landodoughty/Mission-Independent-Avionics-M.I.A.-/README.md

# Mission-Independent-Avionics-M.I.A.-
My Custom Rocket Avionics System
