landodoughty/Mission-Independent-Avionics-M.I.A.-/M.I.A. PCB/amass-xt30pw-m-_-pcb-solder-1.snapshot.2/Amass_XT30PW-M_pcb solder.stp

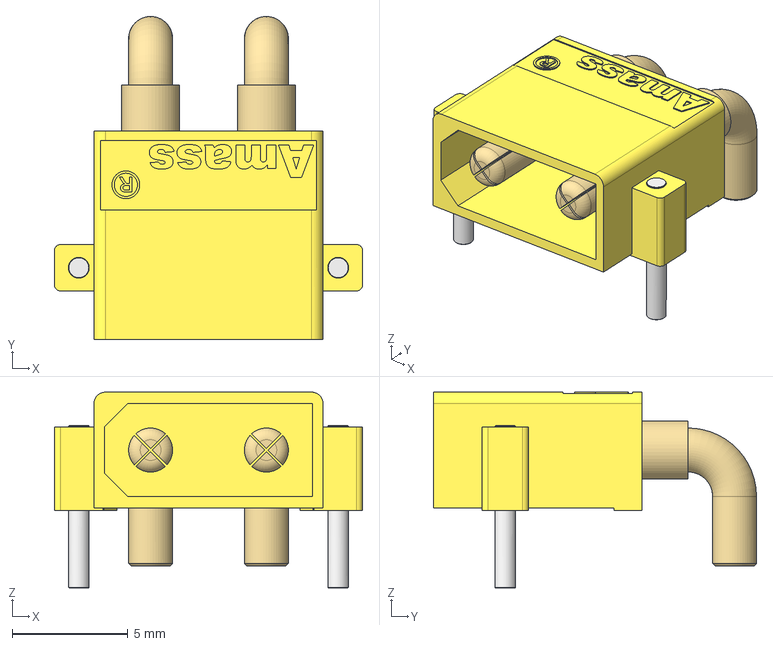
[picture p1: CAD file, 2026-05-28]
M.I.A. PCB/amass-xt30pw-m-_-pcb-solder-1.snapshot.2/Amass_XT30PW-M_pcb solder.stp
13.3 x 13.9 x 8.45 mm
