landodoughty/Mission-Independent-Avionics-M.I.A.-/M.I.A. PCB/ServoPinProtector.step

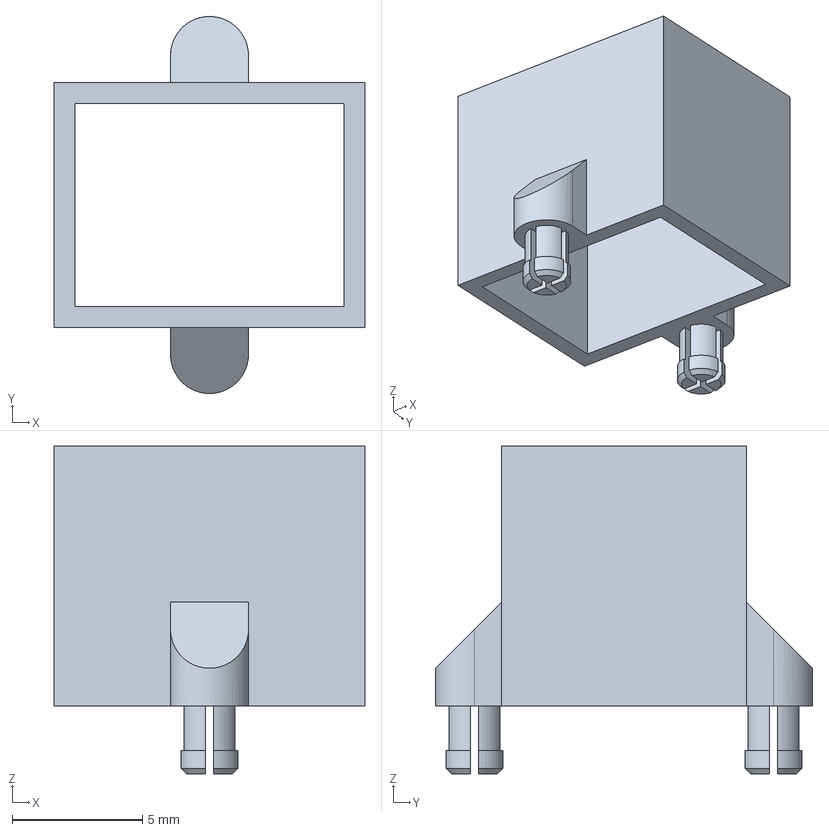
[picture p2: CAD file, 2026-05-28]
M.I.A. PCB/ServoPinProtector.step
12.0 x 14.5 x 12.6 mm
