landodoughty/Mission-Independent-Avionics-M.I.A.-/M.I.A. PCB/ScrewTerminal3d/1985823.stp

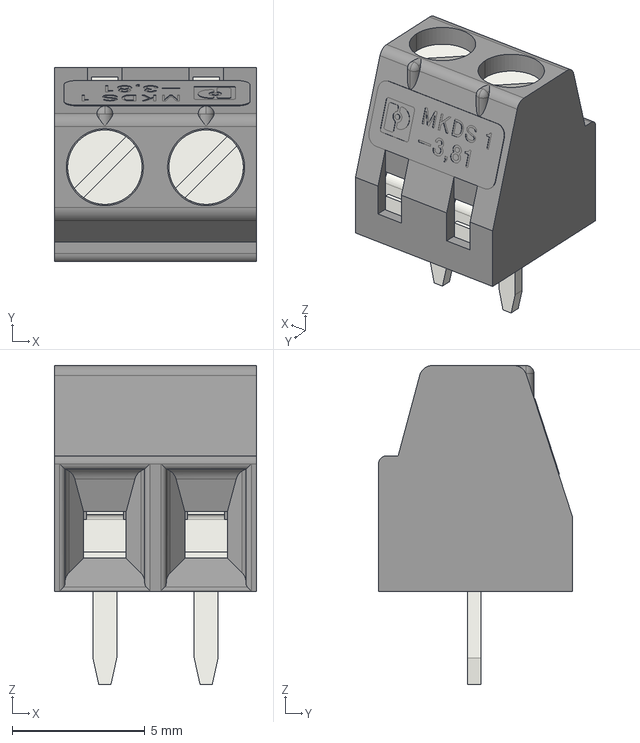
[picture p3: CAD file, 2026-05-28]
M.I.A. PCB/ScrewTerminal3d/1985823.stp
7.61 x 7.30 x 12.0 mm
