landodoughty/Mission-Independent-Avionics-M.I.A.-/M.I.A. PCB/M.I.A..kicad_pcb

## KiCad design M.I.A. PCB/M.I.A..kicad_pcb (2026-09-02)

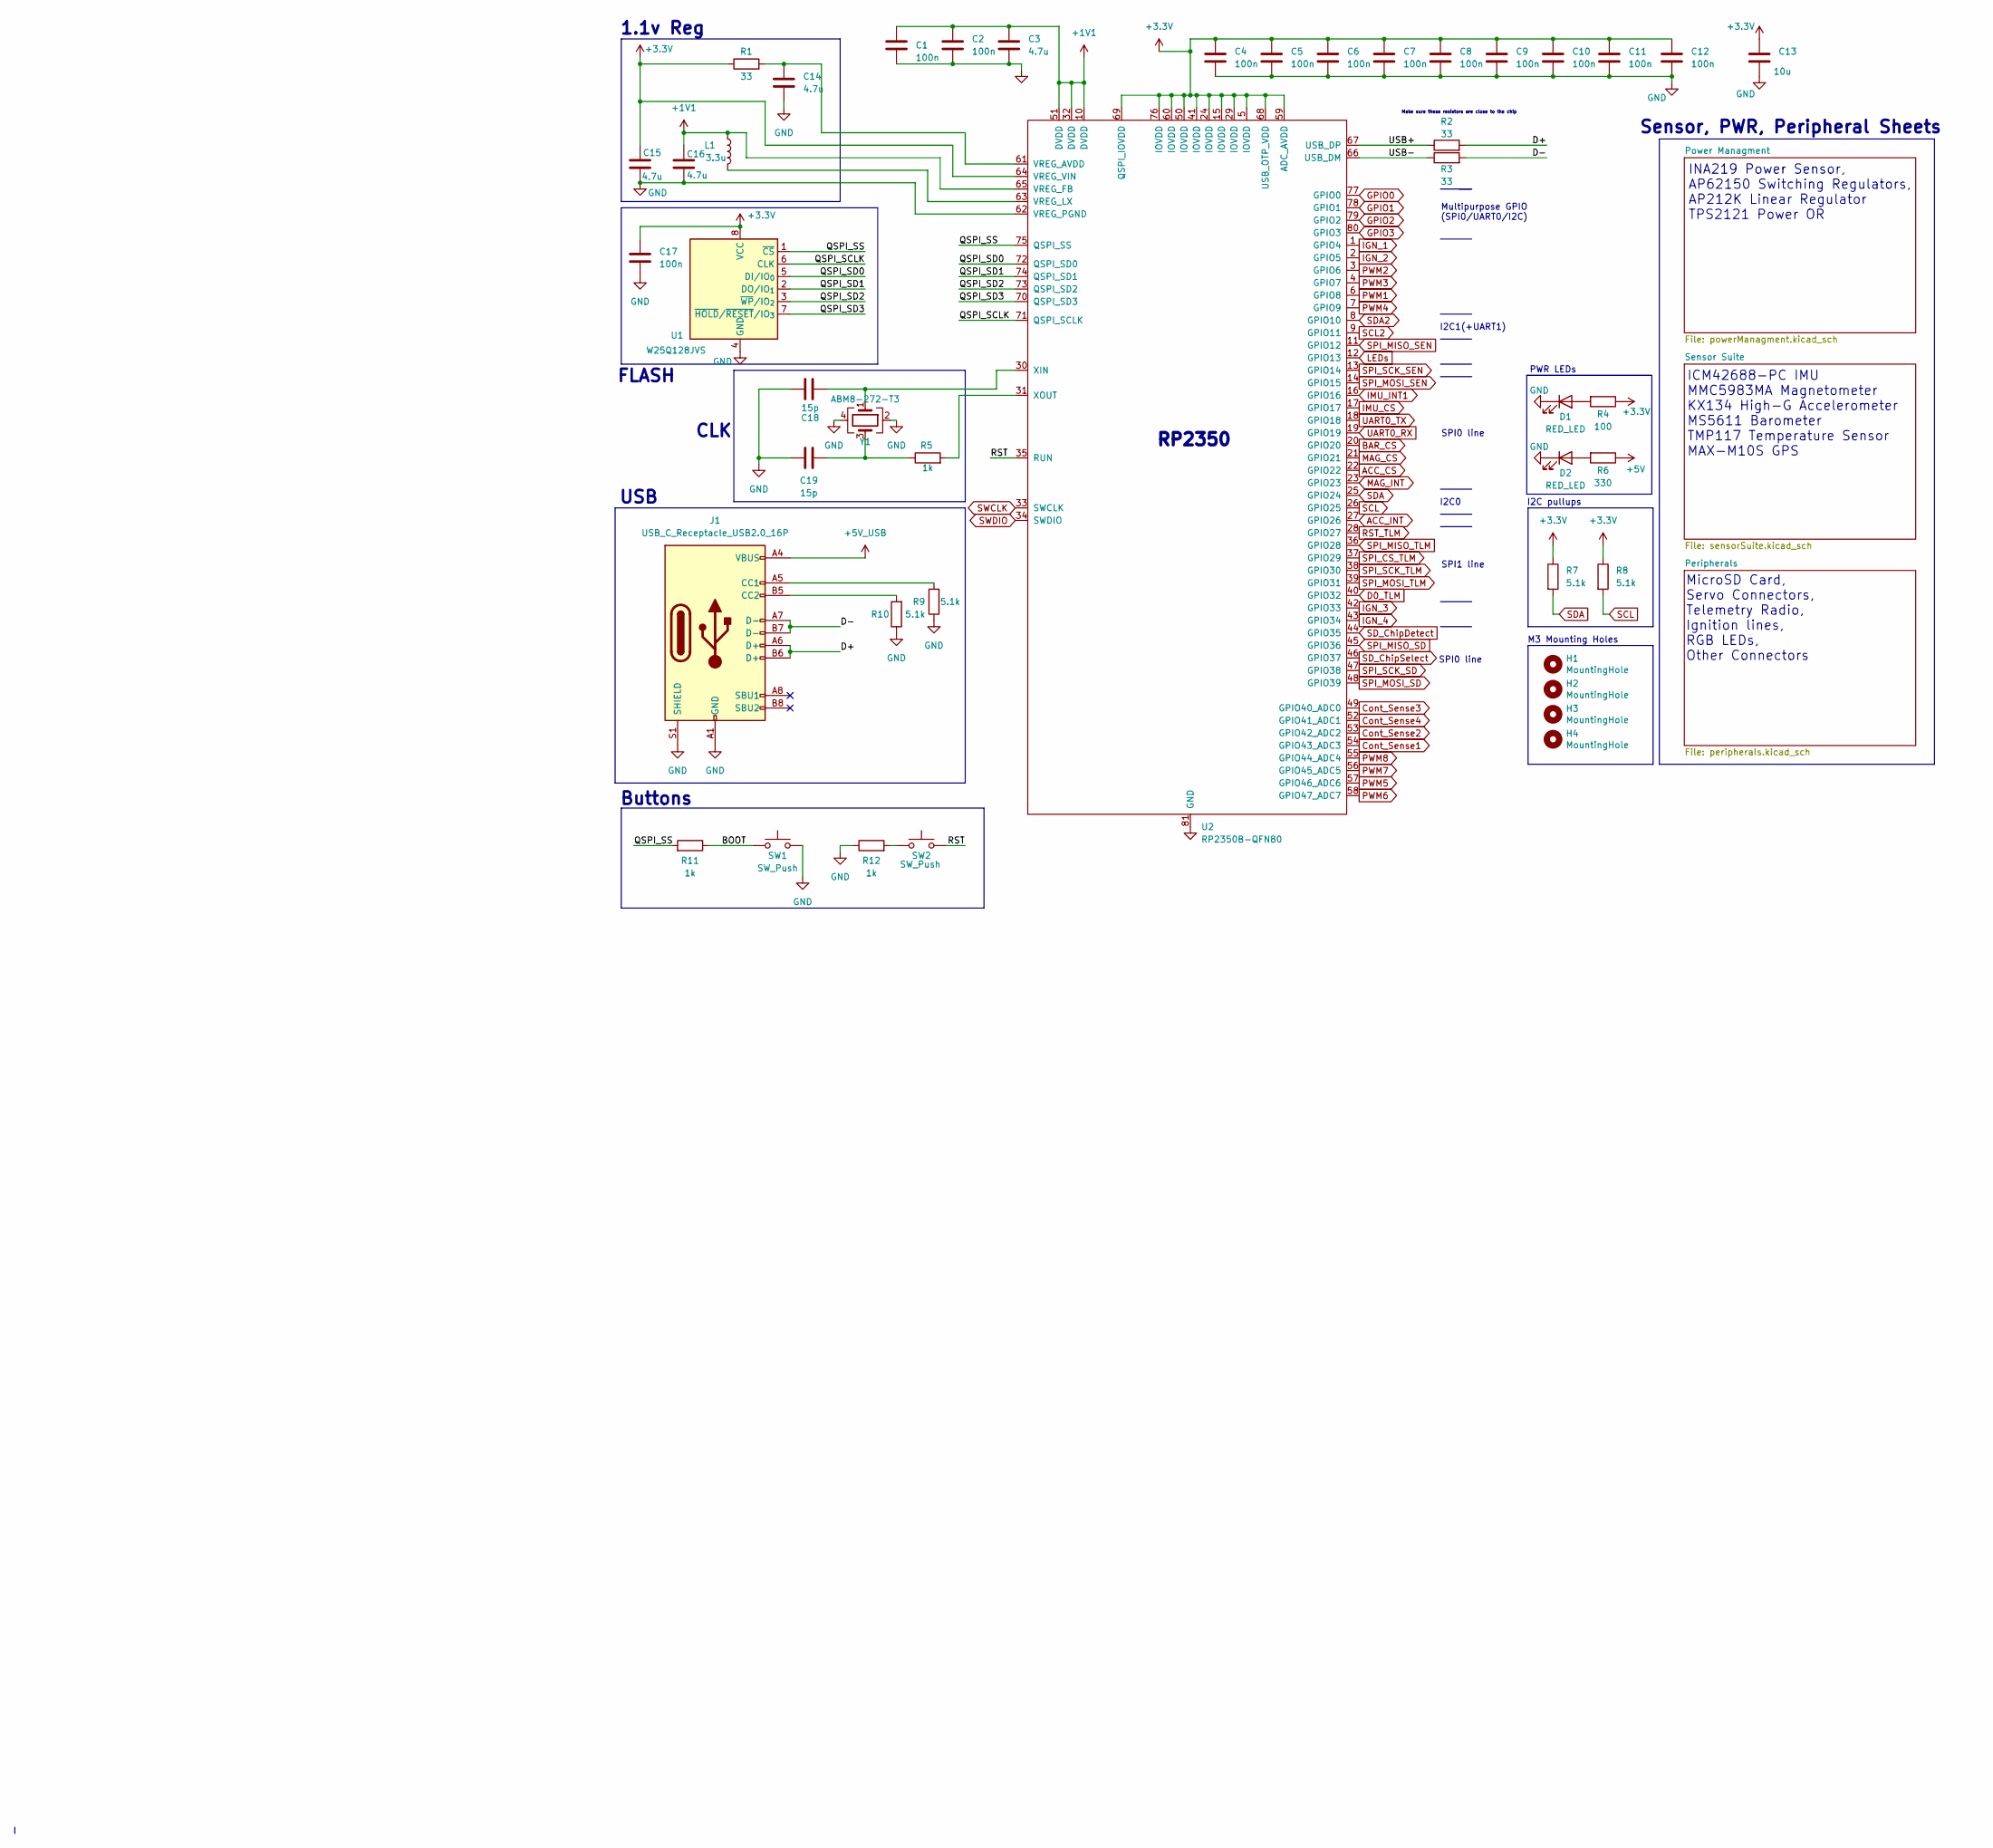
[picture p4: schematic M.I.A..kicad_sch]

Parts:
C1, C2, C4, C5, C6, C7, C8, C9, C10, C11, C12, C17: 100n; C_0603_1608Metric; LCSC Part Number C1525
C3, C14, C15, C16: 4.7u; C_0805_2012Metric; LCSC Part Number C23733
C13: 10u; C_0805_2012Metric; LCSC Part Number C15850
C18, C19: 15p; C_0603_1608Metric; LCSC Part Number C1548
D1, D2: RED_LED; LED_0805_2012Metric; LCSC Part Number C84256
H1, H2, H3, H4: MountingHole; MountingHole_3.2mm_M3_ISO14580_Pad
J1: USB_C_Receptacle_USB2.0_16P; USB_C_Receptacle_HRO_TYPE-C-31-M-12
L1: 3.3u; AOTA-B201610S3R3-101-T(L_0806_2016metric)
R1: 33; R_0603_1608Metric; LCSC Part Number C25105
R2, R3: 33; R_0603_1608Metric; LCSC Part Number C25092
R4: 100; R_0603_1608Metric; LCSC Part Number C25076
R5, R11, R12: 1k; R_0603_1608Metric; LCSC Part Number C11702
R6: 330; R_0603_1608Metric; LCSC Part Number C25076
R7, R8: 5.1k; R_0603_1608Metric; LCSC Part Number C25900
R9, R10: 5.1k; R_0603_1608Metric; LCSC Part Number C25105
SW1, SW2: SW_Push; SW_Push_SPST_NO_Alps_SKRK
U1: W25Q128JVS; WSON-8-1EP_6x5mm_P1.27mm_EP3.4x4mm; LCSC Part Number C97521
U2: RP2350B-QFN80; QFN-80-1EP_10x10mm_P0.4mm_EP3.4x3.4mm
Y1: ABM8-272-T3; Crystal_SMD_3225-4Pin_3.2x2.5mm; LCSC Part Number C20625731

Connections:
+1V1: C1.1, C2.1, C3.1, C16.1, L1.1, U2.10 (DVDD), U2.32 (DVDD), U2.51 (DVDD), U2.65 (VREG_FB)
+3.3V: C4.1, C5.1, C6.1, C7.1, C8.1, C9.1, C10.1, C11.1, C12.1, C13.1, C15.1, C17.1, R1.1, R4.1, R7.1, R8.1, U1.8 (VCC), U2.5 (IOVDD), U2.15 (IOVDD), U2.24 (IOVDD), U2.29 (IOVDD), U2.41 (IOVDD), U2.50 (IOVDD), U2.59 (ADC_AVDD), U2.60 (IOVDD), U2.64 (VREG_VIN), U2.68 (USB_OTP_VDD), U2.69 (QSPI_IOVDD), U2.76 (IOVDD); also elsewhere on the board
+5V: R6.1; also elsewhere on the board
+5V_USB: J1.A4 (VBUS), J1.A9 (VBUS), J1.B4 (VBUS), J1.B9 (VBUS); also elsewhere on the board
/BOOT: R11.1, SW1.2
/D+: J1.A6 (D+), J1.B6 (D+), R2.2
/D-: J1.A7 (D-), J1.B7 (D-), R3.2
/QSPI_SCLK: U1.6 (CLK), U2.71 (QSPI_SCLK)
/QSPI_SD0: U1.5 (DI/IO_{0}), U2.72 (QSPI_SD0)
/QSPI_SD1: U1.2 (DO/IO_{1}), U2.74 (QSPI_SD1)
/QSPI_SD2: U1.3 (~WP/IO_{2}), U2.73 (QSPI_SD2)
/QSPI_SD3: U1.7 (~HOLD/~RESET/IO_{3}), U2.70 (QSPI_SD3)
/QSPI_SS: R11.2, U1.1 (~CS), U2.75 (QSPI_SS)
/RST: SW2.2, U2.35 (RUN)
/USB+: R2.1, U2.67 (USB_DP)
/USB-: R3.1, U2.66 (USB_DM)
ACC_CS: U2.22 (GPIO22); also elsewhere on the board
ACC_INT: U2.27 (GPIO26); also elsewhere on the board
BAR_CS: U2.20 (GPIO20); also elsewhere on the board
Cont_Sense1: U2.54 (GPIO43_ADC3); also elsewhere on the board
Cont_Sense2: U2.53 (GPIO42_ADC2); also elsewhere on the board
Cont_Sense3: U2.49 (GPIO40_ADC0); also elsewhere on the board
Cont_Sense4: U2.52 (GPIO41_ADC1); also elsewhere on the board
D0_TLM: U2.40 (GPIO32); also elsewhere on the board
GND: C1.2, C2.2, C3.2, C4.2, C5.2, C6.2, C7.2, C8.2, C9.2, C10.2, C11.2, C12.2, C13.2, C14.2, C15.2, C16.2, C17.2, C18.1, C19.1, D1.1 (K), D2.1 (K), J1.A1 (GND), J1.A12 (GND), J1.B1 (GND), J1.B12 (GND), J1.S1 (SHIELD), R9.1, R10.1, R12.1, SW1.1, U1.4 (GND), U2.62 (VREG_PGND), U2.81 (GND), Y1.2, Y1.4; also elsewhere on the board
GPIO0: U2.77 (GPIO0); also elsewhere on the board
GPIO1: U2.78 (GPIO1); also elsewhere on the board
GPIO2: U2.79 (GPIO2); also elsewhere on the board
GPIO3: U2.80 (GPIO3); also elsewhere on the board
IGN_1: U2.1 (GPIO4); also elsewhere on the board
IGN_2: U2.2 (GPIO5); also elsewhere on the board
IGN_3: U2.42 (GPIO33); also elsewhere on the board
IGN_4: U2.43 (GPIO34); also elsewhere on the board
IMU_CS: U2.17 (GPIO17); also elsewhere on the board
IMU_INT1: U2.16 (GPIO16); also elsewhere on the board
LEDs: U2.12 (GPIO13); also elsewhere on the board
MAG_CS: U2.21 (GPIO21); also elsewhere on the board
MAG_INT: U2.23 (GPIO23); also elsewhere on the board
unnamed: C19.2, R5.1, Y1.3
unnamed: D1.2 (A), R4.2
unnamed: D2.2 (A), R6.2
unnamed: J1.A5 (CC1), R9.2
unnamed: J1.B5 (CC2), R10.2
unnamed: R12.2, SW2.1
unnamed: C14.1, R1.2, U2.61 (VREG_AVDD)
unnamed: L1.2, U2.63 (VREG_LX)
unnamed: C18.2, U2.30 (XIN), Y1.1
unnamed: R5.2, U2.31 (XOUT)
PWM1: U2.6 (GPIO8); also elsewhere on the board
PWM2: U2.3 (GPIO6); also elsewhere on the board
PWM3: U2.4 (GPIO7); also elsewhere on the board
PWM4: U2.7 (GPIO9); also elsewhere on the board
PWM5: U2.57 (GPIO46_ADC6); also elsewhere on the board
PWM6: U2.58 (GPIO47_ADC7); also elsewhere on the board
PWM7: U2.56 (GPIO45_ADC5); also elsewhere on the board
PWM8: U2.55 (GPIO44_ADC4); also elsewhere on the board
RST_TLM: U2.28 (GPIO27); also elsewhere on the board
SCL: R8.2, U2.26 (GPIO25); also elsewhere on the board
SCL2: U2.9 (GPIO11); also elsewhere on the board
SDA: R7.2, U2.25 (GPIO24); also elsewhere on the board
SDA2: U2.8 (GPIO10); also elsewhere on the board
SD_ChipDetect: U2.44 (GPIO35); also elsewhere on the board
SD_ChipSelect: U2.46 (GPIO37); also elsewhere on the board
SPI_CS_TLM: U2.37 (GPIO29); also elsewhere on the board
SPI_MISO_SD: U2.45 (GPIO36); also elsewhere on the board
SPI_MISO_SEN: U2.11 (GPIO12); also elsewhere on the board
SPI_MISO_TLM: U2.36 (GPIO28); also elsewhere on the board
SPI_MOSI_SD: U2.48 (GPIO39); also elsewhere on the board
SPI_MOSI_SEN: U2.14 (GPIO15); also elsewhere on the board
SPI_MOSI_TLM: U2.39 (GPIO31); also elsewhere on the board
SPI_SCK_SD: U2.47 (GPIO38); also elsewhere on the board
SPI_SCK_SEN: U2.13 (GPIO14); also elsewhere on the board
SPI_SCK_TLM: U2.38 (GPIO30); also elsewhere on the board
SWCLK: U2.33 (SWCLK); also elsewhere on the board
SWDIO: U2.34 (SWDIO); also elsewhere on the board
UART0_RX: U2.19 (GPIO19); also elsewhere on the board
UART0_TX: U2.18 (GPIO18); also elsewhere on the board

Notes on the sheet:
FLASH
Buttons
I2C0
I2C1(+UART1)
I2C pullups
SPI0 line
SPI1 line
MicroSD Card, Servo Connectors, Telemetry Radio, Ignition lines, RGB LEDs, Other Connectors
Make sure these resistors are close to the chip
USB
ICM42688-PC IMU MMC5983MA Magnetometer KX134 High-G Accelerometer MS5611 Barometer TMP117 Temperature Sensor MAX-M10S GPS
Multipurpose GPIO (SPI0/UART0/I2C)
1.1v Reg
INA219 Power Sensor, AP62150 Switching Regulators, AP212K Linear Regulator TPS2121 Power OR
CLK
PWR LEDs
RP2350
M3 Mounting Holes
Sensor, PWR, Peripheral Sheets

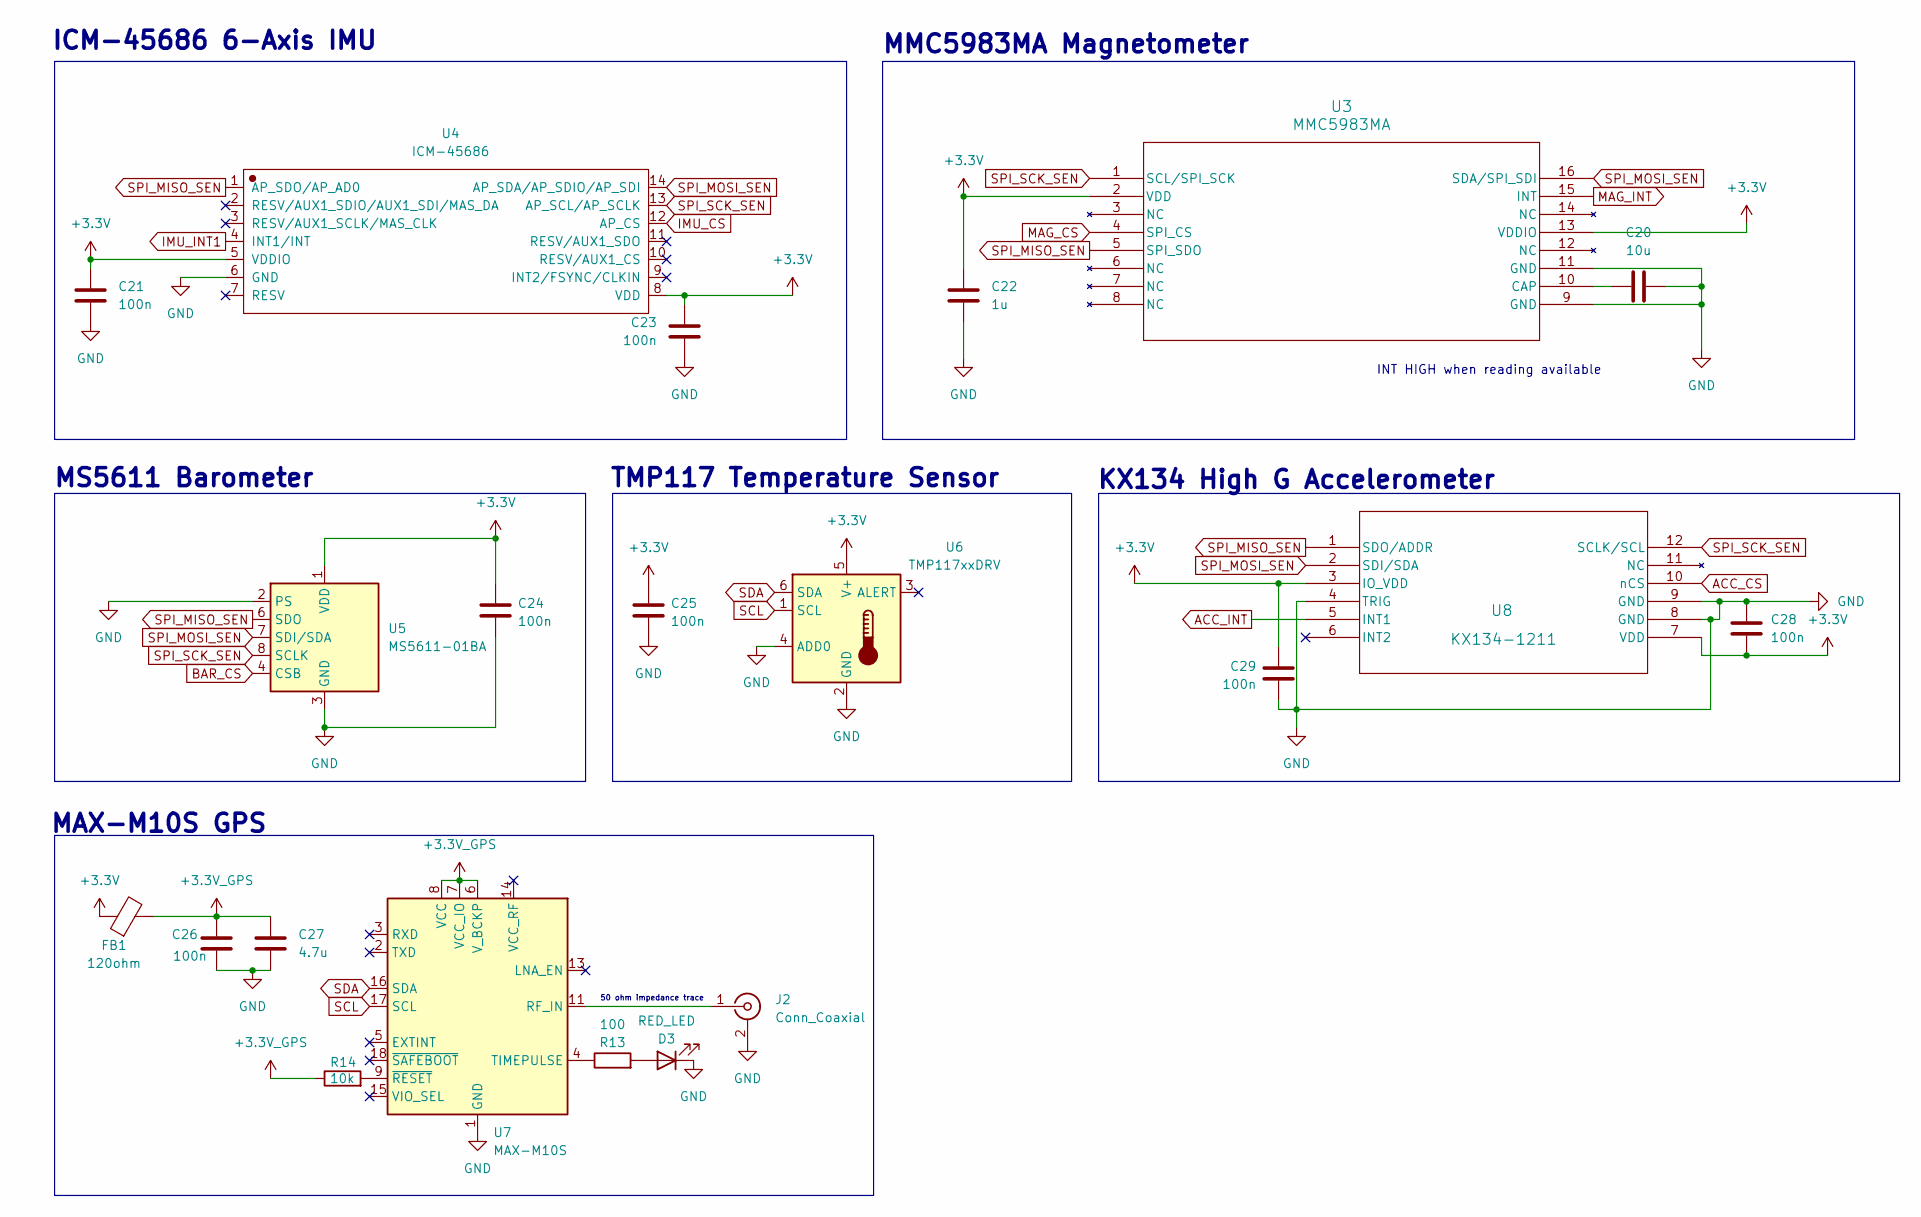
[picture p5: schematic sensorSuite.kicad_sch]

Parts:
C20: 10u; C_0805_2012Metric; LCSC Part Number C15850
C21, C23, C24, C25, C26, C28, C29: 100n; C_0603_1608Metric; LCSC Part Number C1525
C22: 1u; C_0805_2012Metric; LCSC Part Number C28323
C27: 4.7u; C_0805_2012Metric; LCSC Part Number C23733
D3: RED_LED; LED_0805_2012Metric; LCSC Part Number C84256
FB1: 120ohm; L_0805_2012Metric
J2: Conn_Coaxial; SMA_Amphenol_132134-11_Vertical
R13: 100; R_0603_1608Metric; LCSC Part Number C25076
R14: 10k; R_0603_1608Metric; LCSC Part Number C25744
U3: MMC5983MA; LGA-16_3x3mm_P0.5mm; LCSC Part Number C404329
U4: ICM-45686; Bosch_LGA-14_3x2.5mm_P0.5mm; Manufacturer Part ICM-45686; LCSC C22459454
U5: MS5611-01BA; LGA-8_3x5mm_P1.25mm; LCSC Part Number C15639
U6: TMP117xxDRV; WSON-6-1EP_2x2mm_P0.65mm_EP1x1.6mm
U7: MAX-M10S; ublox_MAX
U8: KX134-1211; LGA-12_2x2mm_P0.5mm; LCSC Part Number C2157908

Connections:
+3.3V: C21.1, C22.2, C23.1, C24.1, C25.1, C28.2, C29.1, FB1.1, U3.2 (VDD), U3.13 (VDDIO), U4.5 (VDDIO), U4.8 (VDD), U5.1 (VDD), U6.5 (V+), U8.3 (IO_VDD), U8.7 (VDD); also elsewhere on the board
+3.3V_GPS: C26.1, C27.1, FB1.2, R14.1, U7.6 (V_BCKP), U7.7 (VCC_IO), U7.8 (VCC)
ACC_CS: U8.10 (nCS); also elsewhere on the board
ACC_INT: U8.5 (INT1); also elsewhere on the board
BAR_CS: U5.4 (CSB), U5.5 (CSB); also elsewhere on the board
GND: C20.2, C21.2, C22.1, C23.2, C24.2, C25.2, C26.2, C27.2, C28.1, C29.2, D3.1 (K), J2.2 (Ext), U3.9 (GND), U3.11 (GND), U4.6 (GND), U5.2 (PS), U5.3 (GND), U6.2 (GND), U6.4 (ADD0), U7.1 (GND), U7.10 (GND), U7.12 (GND), U8.4 (TRIG), U8.8 (GND), U8.9 (GND); also elsewhere on the board
IMU_CS: U4.12 (AP_CS); also elsewhere on the board
IMU_INT1: U4.4 (INT1/INT); also elsewhere on the board
MAG_CS: U3.4 (SPI_CS); also elsewhere on the board
MAG_INT: U3.15 (INT); also elsewhere on the board
unnamed: D3.2 (A), R13.2
unnamed: J2.1 (In), U7.11 (RF_IN)
unnamed: C20.1, U3.10 (CAP)
unnamed: R13.1, U7.4 (TIMEPULSE)
unnamed: R14.2, U7.9 (~RESET)
SCL: U6.1 (SCL), U7.17 (SCL); also elsewhere on the board
SDA: U6.6 (SDA), U7.16 (SDA); also elsewhere on the board
SPI_MISO_SEN: U3.5 (SPI_SDO), U4.1 (AP_SDO/AP_AD0), U5.6 (SDO), U8.1 (SDO/ADDR); also elsewhere on the board
SPI_MOSI_SEN: U3.16 (SDA/SPI_SDI), U4.14 (AP_SDA/AP_SDIO/AP_SDI), U5.7 (SDI/SDA), U8.2 (SDI/SDA); also elsewhere on the board
SPI_SCK_SEN: U3.1 (SCL/SPI_SCK), U4.13 (AP_SCL/AP_SCLK), U5.8 (SCLK), U8.12 (SCLK/SCL); also elsewhere on the board

Notes on the sheet:
MMC5983MA Magnetometer
MS5611 Barometer
INT HIGH when reading available
ICM-45686 6-Axis IMU
TMP117 Temperature Sensor
KX134 High G Accelerometer
MAX-M10S GPS
50 ohm impedance trace

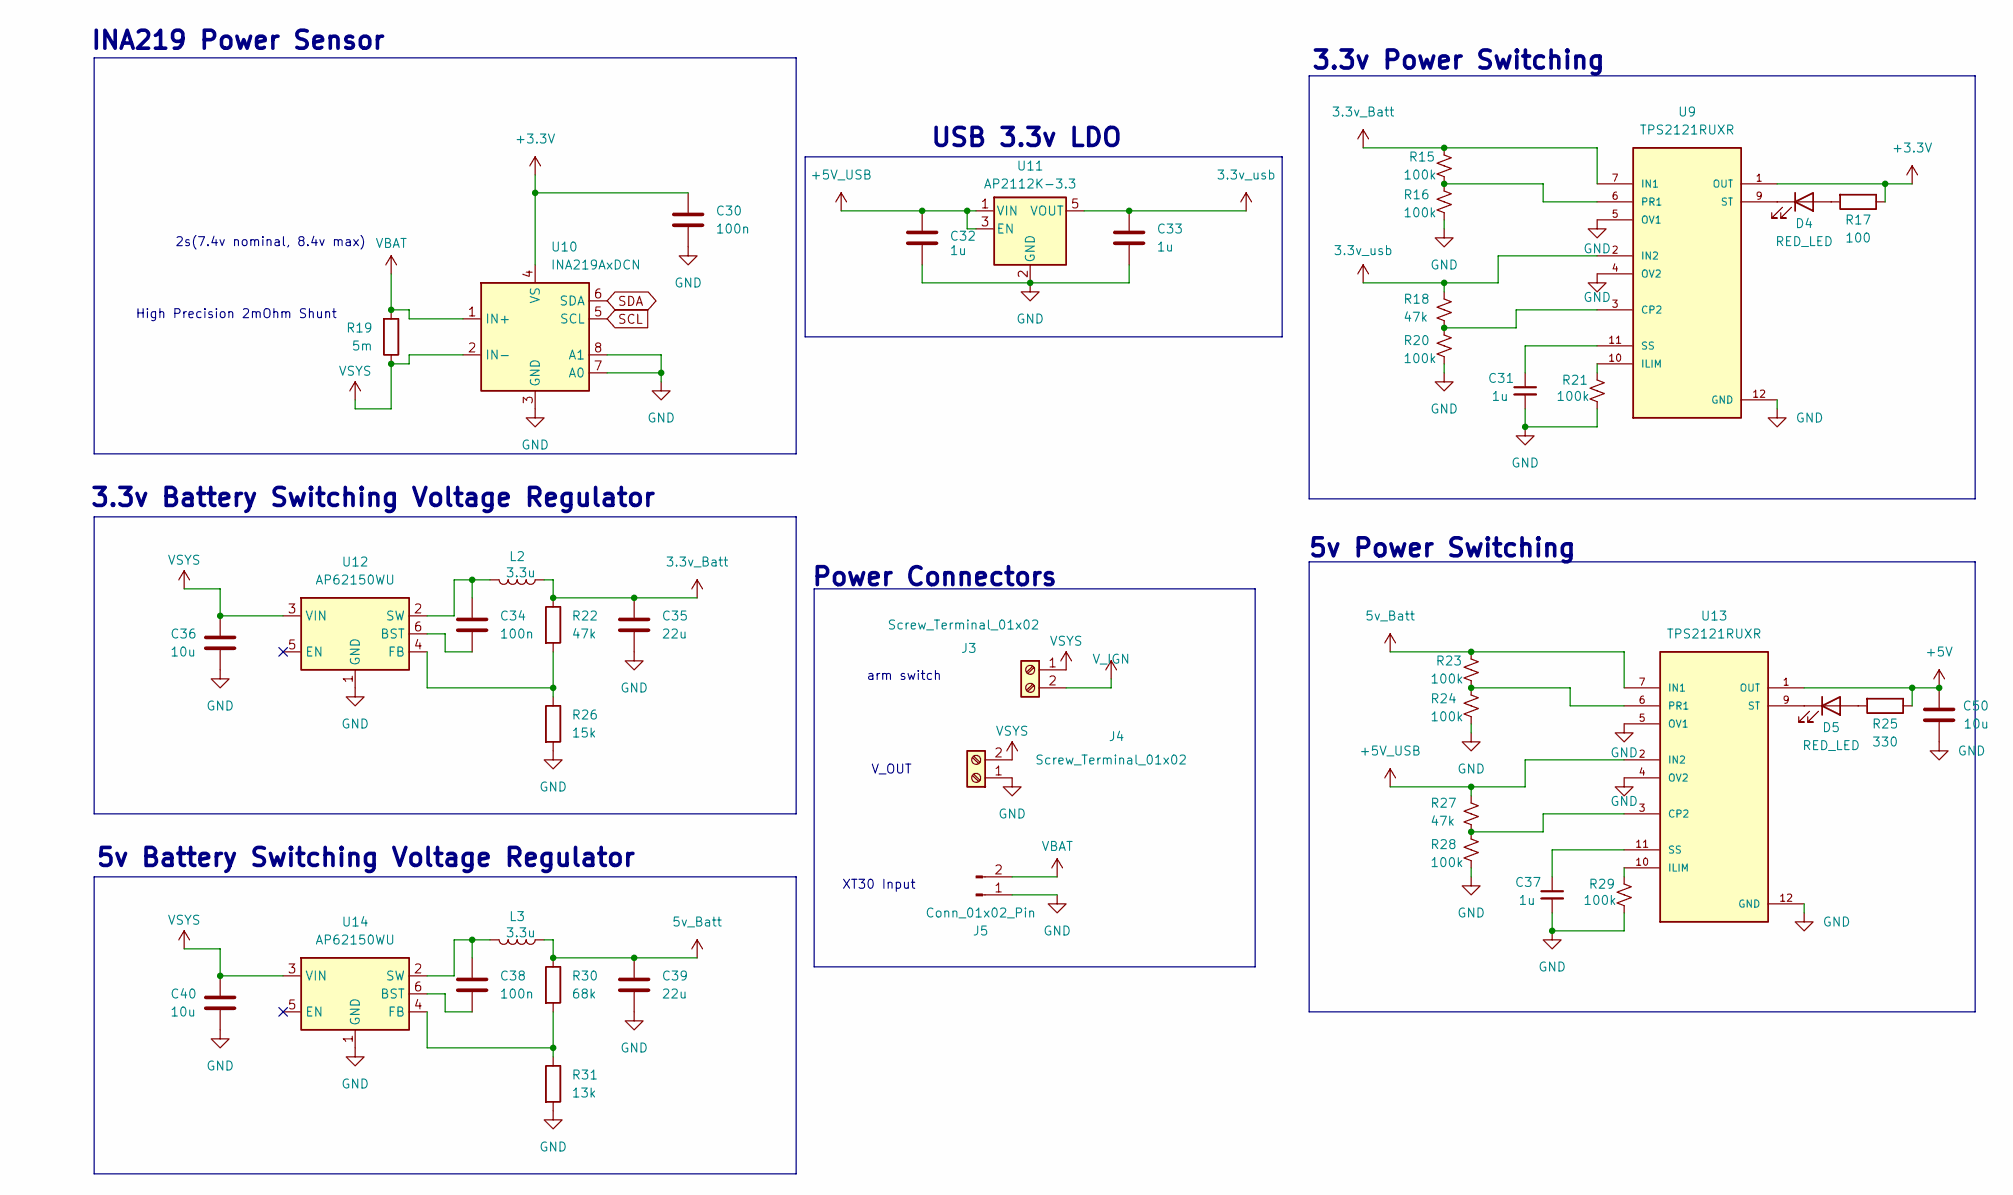
[picture p6: schematic powerManagment.kicad_sch]

Parts:
C30, C34, C38: 100n; C_0603_1608Metric; LCSC Part Number C1525
C31, C37: 1u; C_0805_2012Metric; LCSC Part Number C28323
C32, C33: 1u; C_0805_2012Metric; LCSC Part Number C15850
C35, C39: 22u; C_0805_2012Metric; LCSC Part Number C45783
C36, C40, C50: 10u; C_0805_2012Metric; JLCPCB Part # C15850
D4, D5: RED_LED; LED_0805_2012Metric; LCSC Part Number C84256
J3, J4: Screw_Terminal_01x02; ScrewTerminal_1x02_P3.5mm_Horizontal_Black
J5: Conn_01x02_Pin; AMASS_XT30PW-M_1x02_P2.50mm_Horizontal
L2, L3: 3.3u; AOTA-B201610S3R3-101-T(L_0806_2016metric)
R15, R23: 100k; R_0603_1608Metric; LCSC Part Number C25792
R16, R20, R21, R24, R28, R29: 100k; R_0603_1608Metric; LCSC Part Number C25741
R17: 100; R_0603_1608Metric; LCSC Part Number C25076
R18, R27: 47k; R_0603_1608Metric; LCSC Part Number C25741
R19: 5m; R_1206_3216Metric
R22: 47k; R_0603_1608Metric; LCSC Part Number C25792
R25: 330; R_0603_1608Metric; LCSC Part Number C25076
R26: 15k; R_0603_1608Metric; LCSC Part Number C25756
R30: 68k; R_0603_1608Metric; LCSC Part Number C25792
R31: 13k; R_0603_1608Metric; LCSC Part Number C25756
U9, U13: TPS2121RUXR; Texas_VQFN-HR-12_2x2.5mm_P0.5mm; LCSC Part Number C485916
U10: INA219AxDCN; SOT-23-8
U11: AP2112K-3.3; SOT-23-5
U12, U14: AP62150WU; TSOT-23-6; LCSC Part Number C3194237

Connections:
3.3v_Batt: C35.1, L2.1, R15.1, R22.1, U9.7 (IN1)
3.3v_usb: C33.1, R18.1, U9.2 (IN2), U11.5 (VOUT)
5v_Batt: C39.1, L3.1, R23.1, R30.1, U13.7 (IN1)
+3.3V: C30.1, R17.1, U9.1 (OUT), U9.8 (OUT), U10.4 (VS); also elsewhere on the board
+5V: C50.1, R25.1, U13.1 (OUT), U13.8 (OUT); also elsewhere on the board
+5V_USB: C32.1, R27.1, U11.1 (VIN), U11.3 (EN), U13.2 (IN2); also elsewhere on the board
GND: C30.2, C31.2, C32.2, C33.2, C35.2, C36.2, C37.2, C39.2, C40.2, C50.2, J4.1, J5.1, R16.2, R20.2, R21.2, R24.2, R26.2, R28.2, R29.2, R31.2, U9.4 (OV2), U9.5 (OV1), U9.12 (GND), U10.3 (GND), U10.7 (A0), U10.8 (A1), U11.2 (GND), U12.1 (GND), U13.4 (OV2), U13.5 (OV1), U13.12 (GND), U14.1 (GND); also elsewhere on the board
unnamed: D4.2 (A), R17.2
unnamed: D4.1 (K), U9.9 (ST)
unnamed: D5.2 (A), R25.2
unnamed: D5.1 (K), U13.9 (ST)
unnamed: R18.2, R20.1, U9.3 (CP2)
unnamed: R21.1, U9.10 (ILIM)
unnamed: R15.2, R16.1, U9.6 (PR1)
unnamed: C31.1, U9.11 (SS)
unnamed: C34.2, U12.6 (BST)
unnamed: R22.2, R26.1, U12.4 (FB)
unnamed: C34.1, L2.2, U12.2 (SW)
unnamed: R27.2, R28.1, U13.3 (CP2)
unnamed: R29.1, U13.10 (ILIM)
unnamed: R23.2, R24.1, U13.6 (PR1)
unnamed: C37.1, U13.11 (SS)
unnamed: C38.2, U14.6 (BST)
unnamed: R30.2, R31.1, U14.4 (FB)
unnamed: C38.1, L3.2, U14.2 (SW)
SCL: U10.5 (SCL); also elsewhere on the board
SDA: U10.6 (SDA); also elsewhere on the board
VBAT: J5.2, R19.2, U10.1 (IN+)
VSYS: C36.1, C40.1, J3.1, J4.2, R19.1, U10.2 (IN-), U12.3 (VIN), U14.3 (VIN); also elsewhere on the board
V_IGN: J3.2; also elsewhere on the board

Notes on the sheet:
Power Connectors
3.3v Battery Switching Voltage Regulator
5v Power Switching
arm switch
3.3v Power Switching
V_OUT
INA219 Power Sensor
XT30 Input
5v Battery Switching Voltage Regulator
2s(7.4v nominal, 8.4v max)
USB 3.3v LDO
High Precision 2mOhm Shunt

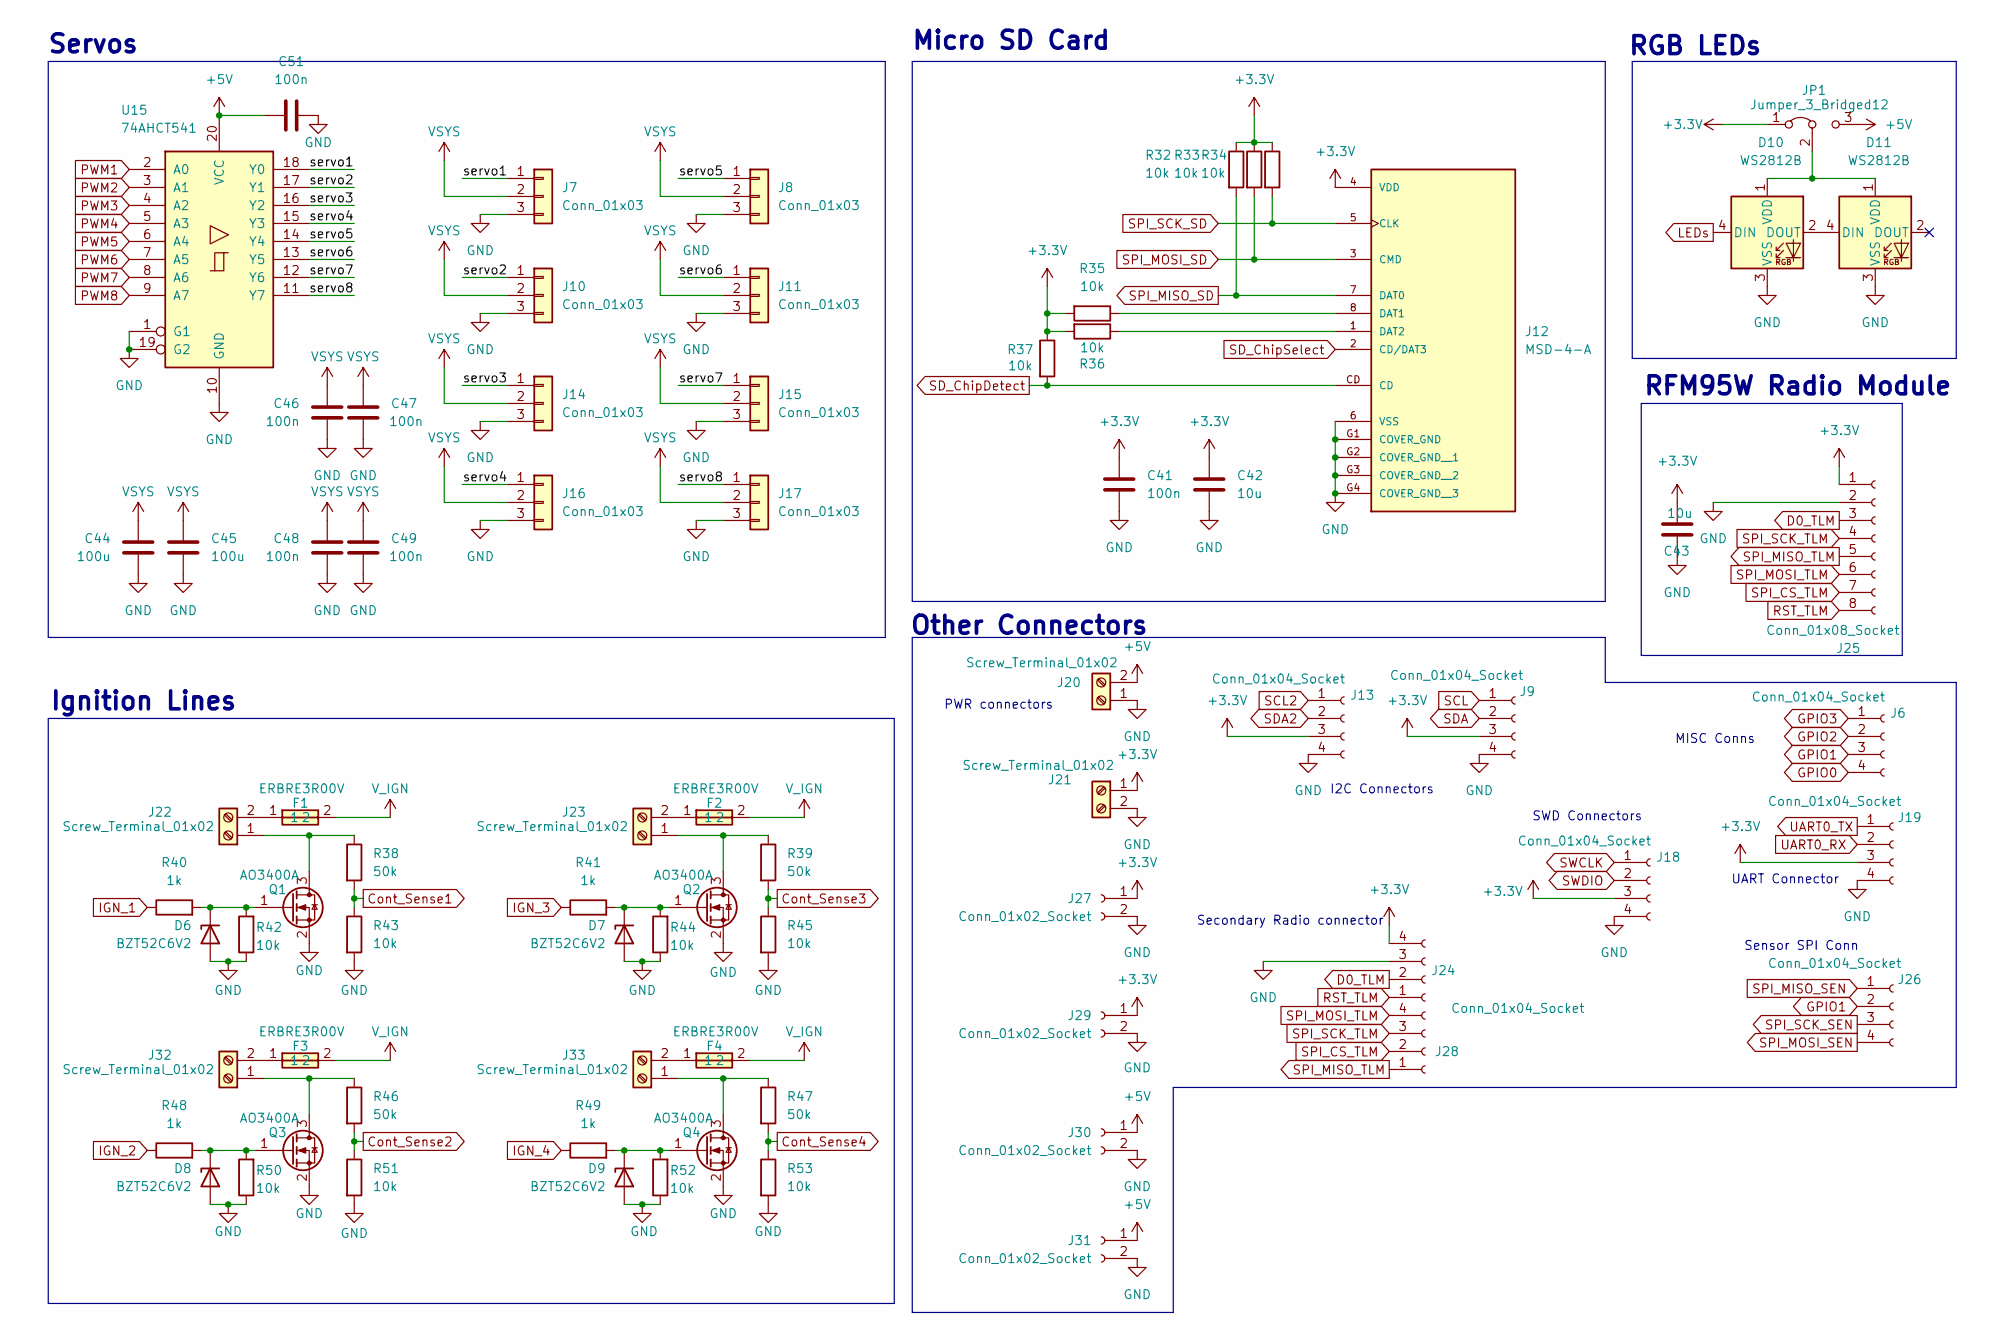
[picture p7: schematic peripherals.kicad_sch]

Parts:
C41, C51: 100n; C_0603_1608Metric; LCSC Part Number C1525
C42: 10u; C_0805_2012Metric; LCSC Part Number C15850
C43: 10u; C_0805_2012Metric
C44, C45: 100u; C_Radial_D5.0mm_H11.0mm_P2.00mm; LCSC Part Number C15850
C46, C47, C48, C49: 100n; C_0603_1608Metric; LCSC Part Number C15850
D6, D7, D8, D9: BZT52C6V2; D_SOD-123F
D10, D11: WS2812B; LED_WS2812B_PLCC4_5.0x5.0mm_P3.2mm
F1, F2, F3, F4: ERBRE3R00V; Manufacturer Part ERBRE3R00V; LCSC C713406
J6, J9, J13, J18, J19, J24, J26, J28: Conn_01x04_Socket; JST_PH_B4B-PH-K_1x04_P2.00mm_Vertical
J7, J8, J10, J11, J14, J15, J16, J17: Conn_01x03; PinHeader_1x03_P2.54mm_Vertical
J12: MSD-4-A; CUI_MSD-4-A; PARTREV 1.0
J20, J21, J22, J23, J32, J33: Screw_Terminal_01x02; ScrewTerminal_1x02_P3.5mm_Horizontal_Black
J25: Conn_01x08_Socket; JST_SHL_SM08B-SHLS-TF_1x08-1MP_P1.00mm_Horizontal
J27, J29, J30, J31: Conn_01x02_Socket; JST_PH_B2B-PH-K_1x02_P2.00mm_Vertical
JP1: Jumper_3_Bridged12; SolderJumper-3_P1.3mm_Bridged12_RoundedPad1.0x1.5mm_NumberL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
Q1, Q2, Q3, Q4: AO3400A; SOT-23
R32, R33, R34, R35, R36, R37: 10k; R_0603_1608Metric; LCSC Part Number C25744
R38, R39, R46, R47: 50k; R_0603_1608Metric
R40, R41, R48, R49: 1k; R_0603_1608Metric
R42, R43, R44, R45, R50, R51, R52, R53: 10k; R_0603_1608Metric
U15: 74AHCT541; SSOP-20_4.4x6.5mm_P0.65mm

Connections:
+3.3V: C41.1, C42.1, C43.1, J9.3, J12.4 (VDD), J13.3, J18.3, J19.3, J21.1, J24.4, J25.1, J27.1, J29.1, JP1.1 (A), R32.1, R33.1, R34.1, R35.2, R36.2, R37.1; also elsewhere on the board
+5V: C51.1, J20.2, J30.1, J31.1, JP1.3 (B), U15.20 (VCC); also elsewhere on the board
/Peripherals/servo1: J7.1, U15.18 (Y0)
/Peripherals/servo2: J10.1, U15.17 (Y1)
/Peripherals/servo3: J14.1, U15.16 (Y2)
/Peripherals/servo4: J16.1, U15.15 (Y3)
/Peripherals/servo5: J8.1, U15.14 (Y4)
/Peripherals/servo6: J11.1, U15.13 (Y5)
/Peripherals/servo7: J15.1, U15.12 (Y6)
/Peripherals/servo8: J17.1, U15.11 (Y7)
Cont_Sense1: R38.2, R43.1; also elsewhere on the board
Cont_Sense2: R46.2, R51.1; also elsewhere on the board
Cont_Sense3: R39.2, R45.1; also elsewhere on the board
Cont_Sense4: R47.2, R53.1; also elsewhere on the board
D0_TLM: J24.2, J25.3; also elsewhere on the board
GND: C41.2, C42.2, C43.2, C44.2, C45.2, C46.2, C47.2, C48.2, C49.2, C51.2, D6.2 (A), D7.2 (A), D8.2 (A), D9.2 (A), D10.3 (VSS), D11.3 (VSS), J7.3, J8.3, J9.4, J10.3, J11.3, J12.6 (VSS), J12.G1 (COVER_GND), J12.G2 (COVER_GND__1), J12.G3 (COVER_GND__2), J12.G4 (COVER_GND__3), J13.4, J14.3, J15.3, J16.3, J17.3, J18.4, J19.4, J20.1, J21.2, J24.3, J25.2, J27.2, J29.2, J30.2, J31.2, Q1.2 (S), Q2.2 (S), Q3.2 (S), Q4.2 (S), R42.1, R43.2, R44.1, R45.2, R50.1, R51.2, R52.1, R53.2, U15.1 (G1), U15.10 (GND), U15.19 (G2); also elsewhere on the board
GPIO0: J6.4; also elsewhere on the board
GPIO1: J6.3, J26.2; also elsewhere on the board
GPIO2: J6.2; also elsewhere on the board
GPIO3: J6.1; also elsewhere on the board
IGN_1: R40.1; also elsewhere on the board
IGN_2: R48.1; also elsewhere on the board
IGN_3: R41.1; also elsewhere on the board
IGN_4: R49.1; also elsewhere on the board
LEDs: D10.4 (DIN); also elsewhere on the board
unnamed: D6.1 (K), Q1.1 (G), R40.2, R42.2
unnamed: D7.1 (K), Q2.1 (G), R41.2, R44.2
unnamed: D8.1 (K), Q3.1 (G), R48.2, R50.2
unnamed: D9.1 (K), Q4.1 (G), R49.2, R52.2
unnamed: D10.2 (DOUT), D11.4 (DIN)
unnamed: D10.1 (VDD), D11.1 (VDD), JP1.2 (C)
unnamed: J12.8 (DAT1), R35.1
unnamed: J12.1 (DAT2), R36.1
unnamed: J22.1, Q1.3 (D), R38.1
unnamed: F1.1, J22.2
unnamed: J23.1, Q2.3 (D), R39.1
unnamed: F2.1, J23.2
unnamed: J32.1, Q3.3 (D), R46.1
unnamed: F3.1, J32.2
unnamed: J33.1, Q4.3 (D), R47.1
unnamed: F4.1, J33.2
PWM1: U15.2 (A0); also elsewhere on the board
PWM2: U15.3 (A1); also elsewhere on the board
PWM3: U15.4 (A2); also elsewhere on the board
PWM4: U15.5 (A3); also elsewhere on the board
PWM5: U15.6 (A4); also elsewhere on the board
PWM6: U15.7 (A5); also elsewhere on the board
PWM7: U15.8 (A6); also elsewhere on the board
PWM8: U15.9 (A7); also elsewhere on the board
RST_TLM: J24.1, J25.8; also elsewhere on the board
SCL: J9.1; also elsewhere on the board
SCL2: J13.1; also elsewhere on the board
SDA: J9.2; also elsewhere on the board
SDA2: J13.2; also elsewhere on the board
SD_ChipDetect: J12.CD, R37.2; also elsewhere on the board
SD_ChipSelect: J12.2 (CD/DAT3); also elsewhere on the board
SPI_CS_TLM: J25.7, J28.2; also elsewhere on the board
SPI_MISO_SD: J12.7 (DAT0), R32.2; also elsewhere on the board
SPI_MISO_SEN: J26.1; also elsewhere on the board
SPI_MISO_TLM: J25.5, J28.1; also elsewhere on the board
SPI_MOSI_SD: J12.3 (CMD), R33.2; also elsewhere on the board
SPI_MOSI_SEN: J26.4; also elsewhere on the board
SPI_MOSI_TLM: J25.6, J28.4; also elsewhere on the board
SPI_SCK_SD: J12.5 (CLK), R34.2; also elsewhere on the board
SPI_SCK_SEN: J26.3; also elsewhere on the board
SPI_SCK_TLM: J25.4, J28.3; also elsewhere on the board
SWCLK: J18.1; also elsewhere on the board
SWDIO: J18.2; also elsewhere on the board
UART0_RX: J19.2; also elsewhere on the board
UART0_TX: J19.1; also elsewhere on the board
VSYS: C44.1, C45.1, C46.1, C47.1, C48.1, C49.1, J7.2, J8.2, J10.2, J11.2, J14.2, J15.2, J16.2, J17.2; also elsewhere on the board
V_IGN: F1.2, F2.2, F3.2, F4.2; also elsewhere on the board

Notes on the sheet:
Servos
UART Connector
Sensor SPI Conn
RGB LEDs
SWD Connectors
MISC Conns
I2C Connectors
Ignition Lines
PWR connectors
Other Connectors
Micro SD Card
RFM95W Radio Module
Secondary Radio connector
