landodoughty/Mission-Independent-Avionics-M.I.A.-/M.I.A. PCB/M.I.A..kicad_pcb

## KiCad design M.I.A. PCB/M.I.A..kicad_pcb (continued)

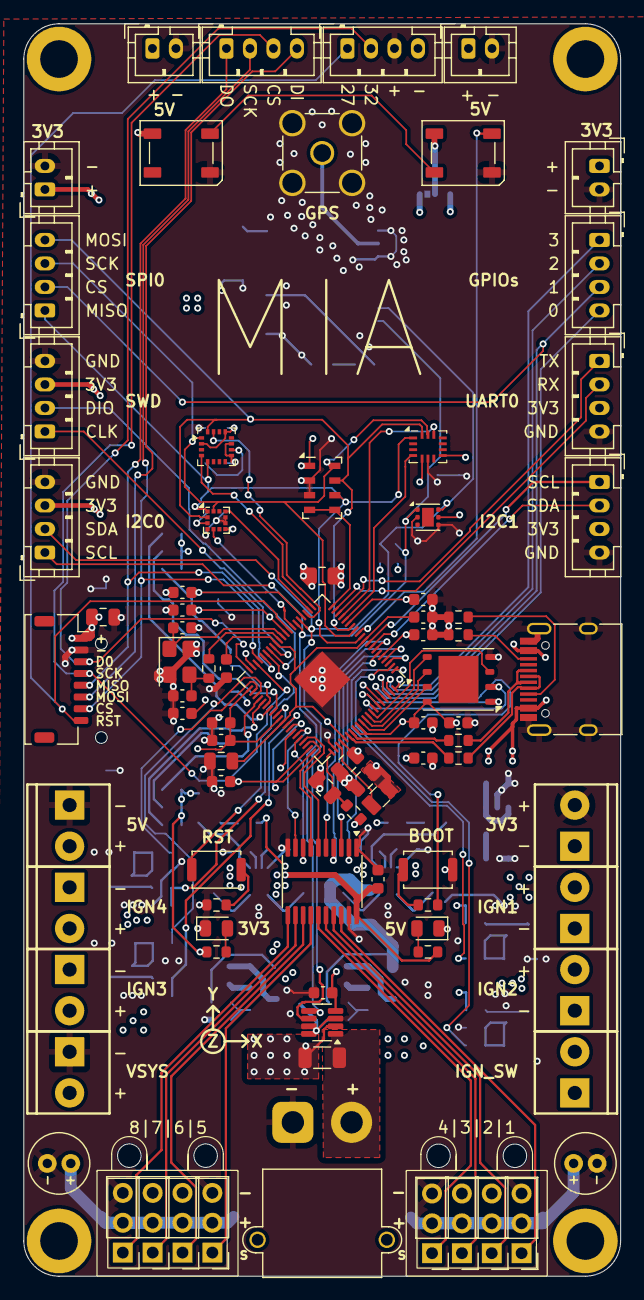
[picture p8: board M.I.A..kicad_pcb from above]

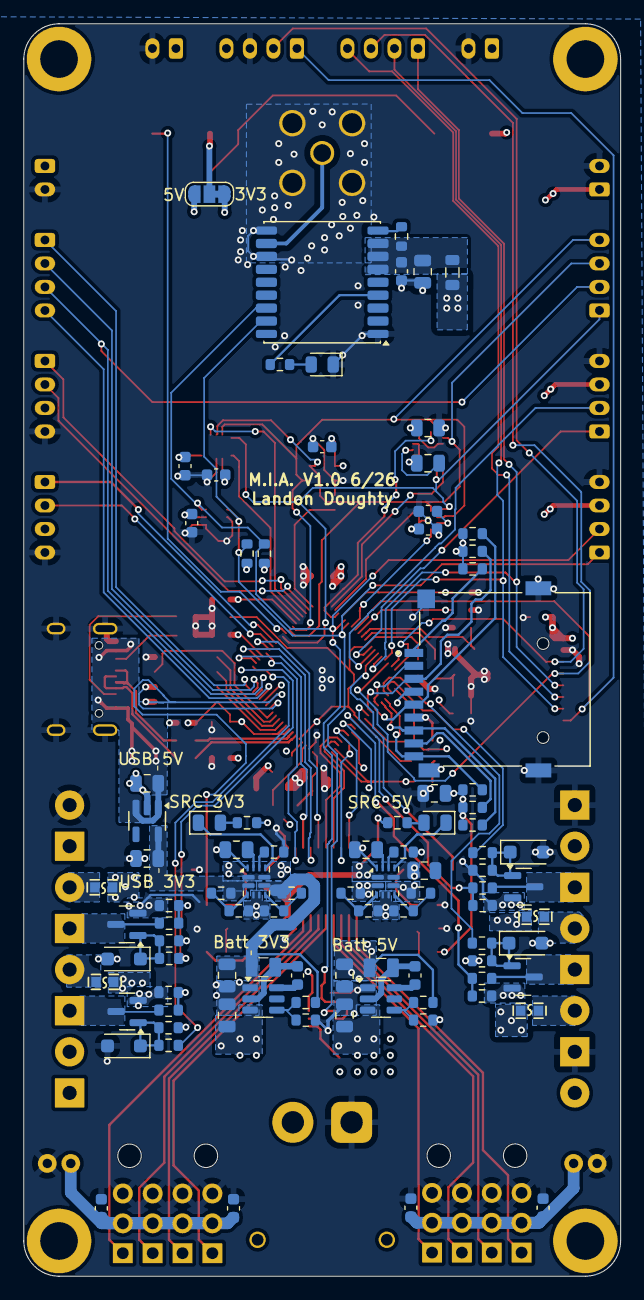
[picture p9: board M.I.A..kicad_pcb from below]

Board: 4 copper layers, 50.8 x 106.6 mm, 186 parts (94 on the bottom side), 131 nets.

Other parts of the board:
G1, G2: 3x4PinHeaderCase90deg
G3: orientationIndicator
