landodoughty/Mission-Independent-Avionics-M.I.A.-/(commit log)

2026-05-25 Add ignore.gitignore for Python Cache and Temporary KiCad files
2026-05-25 Delete GroundStationDisplay/__pycache__ directory
    removed pycache files
2026-05-25 Added new files for the Ground Station and M.I.A. Code.
2026-05-25 added pcb files
    [M.I.A..kicad_pcb, M.I.A..kicad_sch, peripherals.kicad_sch, powerManagment.kicad_sch, sensorSuite.kicad_sch]
2026-05-26 Started Layout
    [M.I.A..kicad_pcb]
2026-05-27 Worked on Layout, Changed IMU
    [M.I.A..kicad_pcb, peripherals.kicad_sch, powerManagment.kicad_sch, sensorSuite.kicad_sch]
2026-05-28 added servo pin protector and changed screw terminal size
    [1985823.stp, Amass_XT30PW-M_pcb solder.stp, M.I.A..kicad_pcb, ServoPinProtector.step, peripherals.kicad_sch, powerManagment.kicad_sch]
2026-05-28 updated LDO and Power Sensor
    may need to change LDO to support power draw of RFM95CW
    [M.I.A..kicad_pcb, peripherals.kicad_sch, powerManagment.kicad_sch]
2026-05-30 Finished Layout other than gps, extra connectors, and ignition lines
    [M.I.A..kicad_pcb, M.I.A..kicad_sch, peripherals.kicad_sch, powerManagment.kicad_sch, sensorSuite.kicad_sch]
2026-06-01 Worked More on Layout/Wiring
    [M.I.A..kicad_pcb, M.I.A..kicad_sch, peripherals.kicad_sch, powerManagment.kicad_sch]
2026-06-02 Wired Sensors
    [M.I.A..kicad_pcb, M.I.A..kicad_sch, peripherals.kicad_sch, sensorSuite.kicad_sch]
2026-06-05 routed continuity sensing and pwm routing fixed
    [M.I.A..kicad_pcb, M.I.A..kicad_sch]
2026-06-10 Routed GPS Maybe Correctly
    [M.I.A..kicad_pcb, M.I.A..kicad_sch, peripherals.kicad_sch, powerManagment.kicad_sch, sensorSuite.kicad_sch]
2026-06-10 Routed two ignition lines
    [M.I.A..kicad_pcb, M.I.A..kicad_sch, powerManagment.kicad_sch]
2026-06-12 Added LEDs, Prepped for 4 layer conversion
    [M.I.A..kicad_pcb, M.I.A..kicad_sch, peripherals.kicad_sch, powerManagment.kicad_sch, sensorSuite.kicad_sch]
2026-06-12 6 to 4 layer conversion
    [M.I.A..kicad_pcb]
2026-06-12 Updated top connectors to be TLM_SPI
    [M.I.A..kicad_pcb, M.I.A..kicad_sch, peripherals.kicad_sch, powerManagment.kicad_sch, sensorSuite.kicad_sch]
2026-06-15 routed ign3/4, fixed some drc
    [M.I.A..kicad_pcb, M.I.A..kicad_sch]
2026-06-16 Final Fixes, impedances, silkscreen etc
    [M.I.A..kicad_pcb, M.I.A..kicad_sch, bom.csv, designators.csv, peripherals.kicad_sch, positions.csv]
2026-06-16 More Small Updates/Improvements
    [M.I.A..kicad_pcb, M.I.A..kicad_sch, peripherals.kicad_sch, powerManagment.kicad_sch, sensorSuite.kicad_sch]
2026-06-25 Likely Final PCB
    [M.I.A..kicad_pcb, bom.csv, designators.csv, peripherals.kicad_sch, positions.csv]
2026-08-03 Routing Updates
    [M.I.A..kicad_pcb, M.I.A..kicad_sch, powerManagment.kicad_sch]
2026-09-02 Added Test Points + Back Graphics
    [M.I.A..kicad_pcb, M.I.A..kicad_sch, peripherals.kicad_sch, powerManagment.kicad_sch, sensorSuite.kicad_sch]
